etherkit/OpenBeacon/documentation/OpenBeacon BOM.txt

OpenBeacon BOM
Etherkit
15 Aug 2012

| Part (marking)                  | Qty  | Ref                            | P/N
======================================================================================================
Capacitors
| 100n (104)                        12    C1, C2, C9, C10, C11, C13,
                                          C14, C15, C16, C17, C18, C19       
Diodes
| Green LED (5 mm)                  1     D2        
| Red LED (5 mm)                    2     D1, D7        
| 1N5817                            4     D4, D6, D8, D9        
| 1N5227B (3.6V zener)              2     D3, D5        

Connectors
| BNC                               1     J4                                Amphenol 31-5431-10RFX       
| AVR-ISP-6                         1     J3                                3M 929836-09-03      
| +12VDC                            1     J1                                Kobiconn 163-762-E    
| USB B Jack                        1     J2                                FCI 61729-1011BLF

Transistors
| 2N4401                            2     Q1, Q2        
| 2N4403                            1     Q4        
| 2N7000                            1     Q5        
| BD139-16                          1     Q3        

Resistors & Trimmers (0.25 W, unless specified, tolerance band omitted below)
| 1 (brown-black-black-silver)      1     R25  
| 1.5k (brown-green-black-brown)    1     R15       
| 10 (brown-black-black-gold)       2     R13, R21       
| 100k (brown-black-black-orange)   1     R24           
| 10k (brown-black-black-red)       4     R5, R6, R9, R12        
| 1k (brown-black-black-brown)      2     R16, R18  
| 150k (brown-green-black-orange)   3     R1, R2, R3     
| 22 (red-red-black-gold)           2     R14, R19       
| 22k (red-red-black-red)           2     R22, R23
| 330 (orange-orange-black-black)   1     R4
| 4.7k (yellow-purple-black-brown)  1     R17        
| 47 (yellow-purple-black-gold)     1     R7        
| 68 (blue-grey-black-gold)         2     R10, R11   
| 470 trim                          1     R20                               Bournes 3319P-1-471 

Buttons
| Pushbutton                        1     S1                                TE 1571010-1

Transformers
| FT37-43 10T BIFILAR               1     T1        

ICs
| 78L05                             1     U2        
| ATTINY85-20                       1     U1 

Frequency Dependent Components
            |R8
80 Meters   |2.2k (red-red-black-brown)
40 Meters   |2.2k (red-red-black-brown)
30 Meters   |2.2k (red-red-black-brown)
10 Meters   |470 (yellow-purple-black-black)

            |C3         |C4            |C5          |C6          |C7/C8         |C12        |C20/C24      
80 Meters   |20 (red)   |15 C0G (15)   |50 (yellow) |N/A         |150 C0G (151) |68 (68)    |820 (821)
40 Meters   |20 (red)   |10 C0G (10)   |30 (green)  |N/A         |100 C0G (101) |68 (68)    |390 (391)
30 Meters   |10 (blue)  |3.3 C0G (3R3) |30 (green)  |N/A         |47 C0G (47)   |47 (47)    |330 (331)    
10 Meters   |10 (blue)  |2.2 C0G (2.2) |20 (red)    |N/A         |4.7 C0G (4.7) |22 (22)    |180 (181)

            |C22        |C21/C23 |L1/L2                                |L3/L4                         
80 Meters   |1500 (152) |N/A     |22 u (red-red-black, green body)     |3.13 u T37-2 28T (red core)   
40 Meters   |680 (681)  |N/A     |10 u (brown-black-black, green body) |1.46 u T37-2 18T (red core)   
30 Meters   |560 (561)  |N/A     |10 u (brown-black-black, green body) |1.1 u T37-2 16T (red core)    
10 Meters   |270 (271)  |N/A     |1 u (brown-black-gold, green body)   |330 n T37-6 10T (yellow core) 

            |X1
80 Meters   |3.582 MHz
40 Meters   |7.040 MHz
30 Meters   |10.140 MHz
10 Meters   |28.000 MHz

Miscellaneous
| Red Magnet Wire, 28 AWG (feet)    4
| Green Magnet Wire, 28 AWG (feet)  1
| DIP-8 socket                      1                                       FCI DILB8P-223TLF
| PCB
