etherkit/OpenBeacon/documentation/OpenBeacon Windows Build Env Installation.odt

MinGW Installation

1. Review the instructions at http://www.mingw.org/wiki/Getting_Started
2. Download the latest mingw-get-inst from http://sourceforge.net/projects/mingw/files/Installer/mingw-get-inst/
3. Run the executable file and accept all default settings in the installation wizard (MinGW is installed to C:\MinGW)
4. Add C:\MinGW\bin; to the system PATH (instructions to come)

libusb-win32 Installation

5. Download the latest libusb-win32-bin-x.x.x.x from http://sourceforge.net/projects/libusb-win32/files/
6. Unzip the libusb-win32-bin-x.x.x.x ZIP file to a temporary directory
7. In libusb-win32-bin-x.x.x.x\include, rename lusb0_usb.h to usb.h, then copy usb.h to C:\MinGW\include
8. Copy libusb.a from libusb-win32-bin-x.x.x.x\lib\gcc to C:\MinGW\lib
10. In the directory where the openbeacon.c is located, execute gcc openbeacon.c -o openbeacon.exe -lusb
