etherkit/OpenBeacon/documentation/OpenBeacon Schematic Annotated.pdf

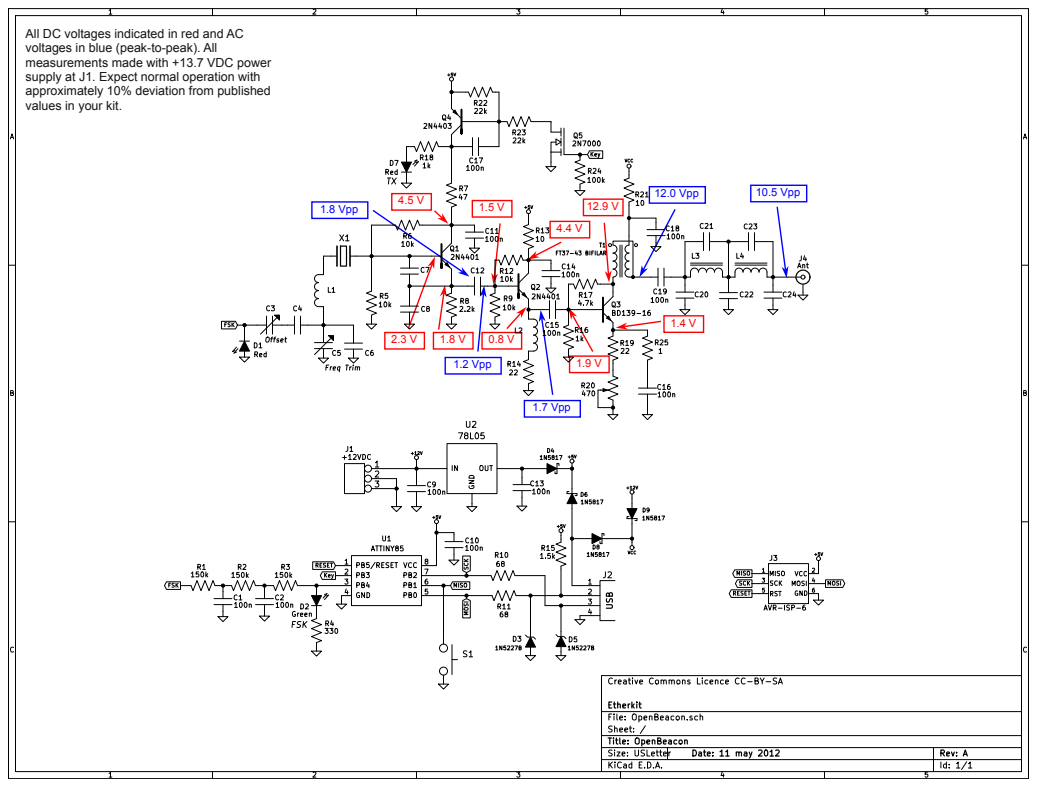
[picture p1: page 1]
1.8 Vpp; 1.2 Vpp; 1.7 Vpp; 12.0 Vpp; 10.5 Vpp

All DC voltages indicated in red and AC
voltages in blue (peaktopeak). All
measurements made with +13.7 VDC power
supply at J1. Expect normal operation with
approximately 10% deviation from published
values in your kit.
