etherkit/OpenBeacon/documentation/OpenBeacon Schematic.pdf

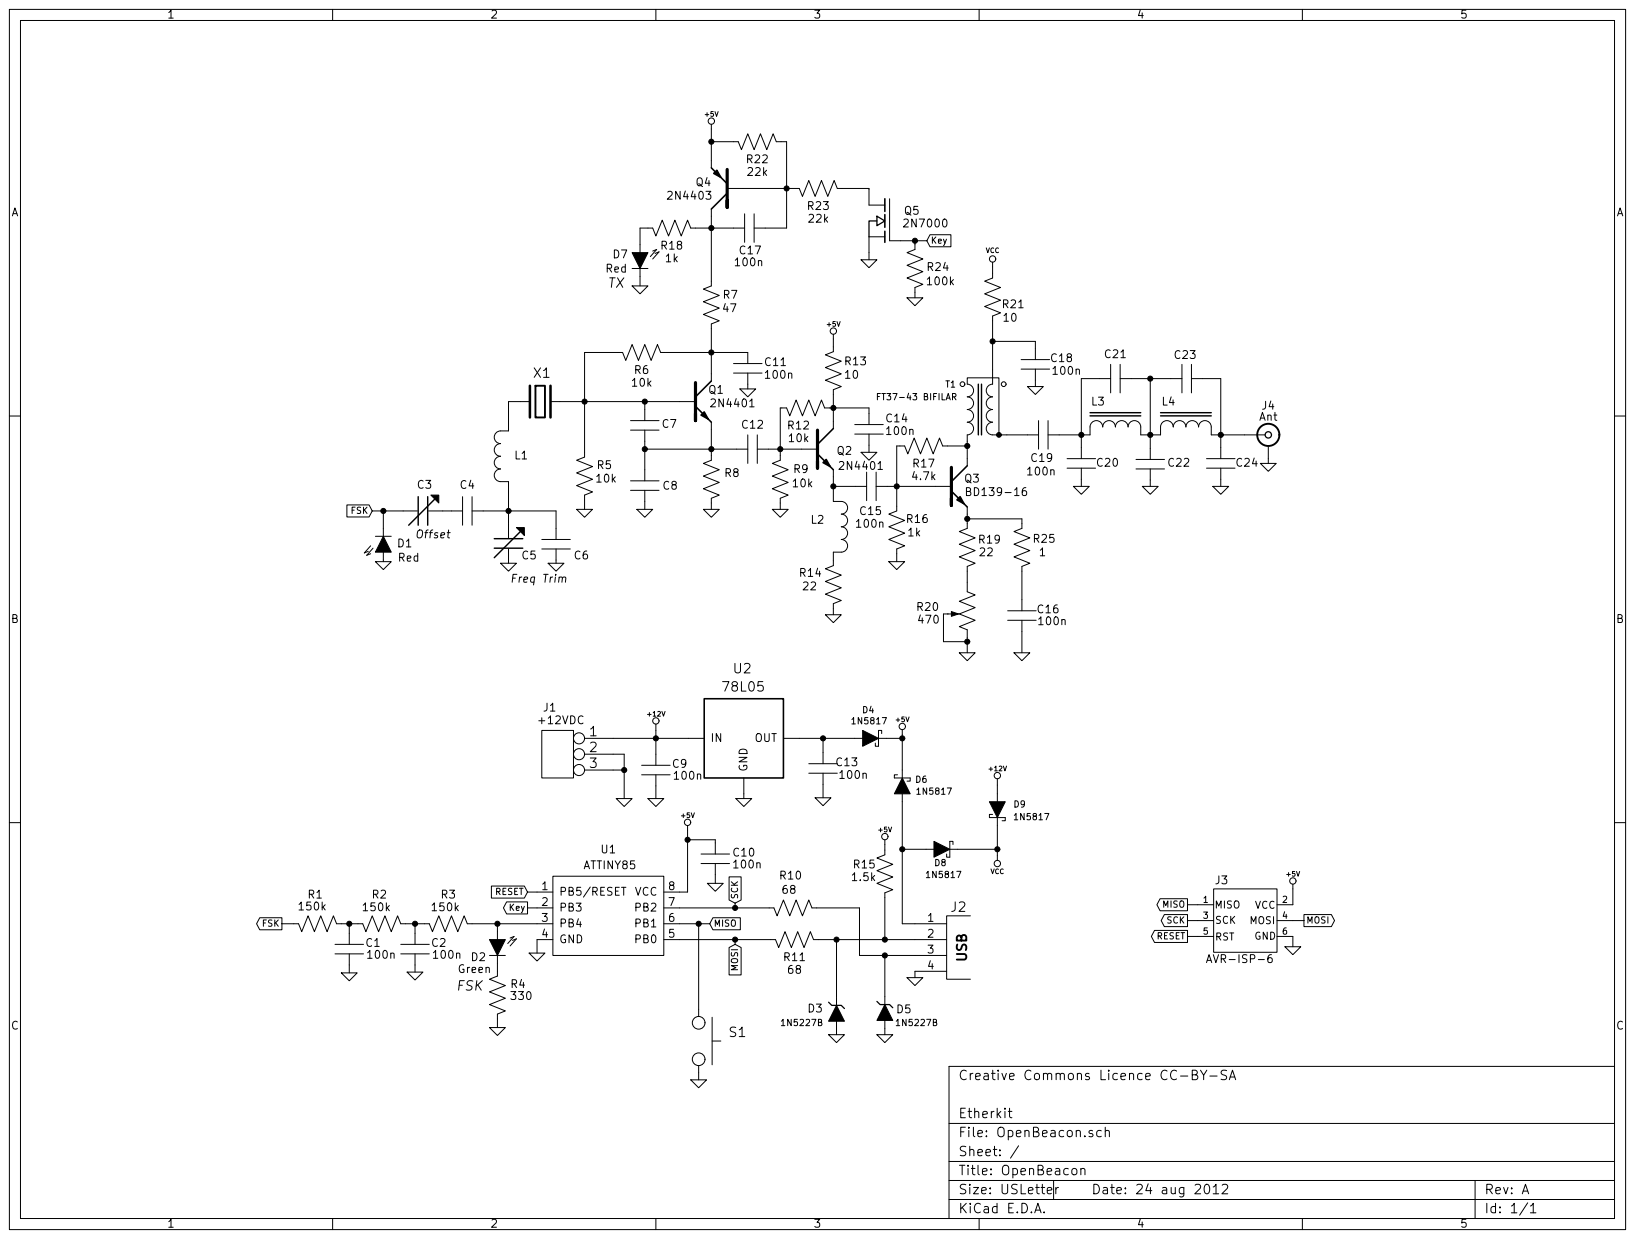
[picture p2: page 1]
