etherkit/OpenBeacon/pcb/OpenBeacon.sch

## KiCad design pcb/OpenBeacon.sch (2012-08-24, an earlier design)

Schematic: OpenBeacon.sch

Parts:
C1, C2, C9, C10, C11, C12, C13, C14, C15, C16, C17, C18, C19: 100n
C3, C5: CTRIM
C4, C6, C7, C8, C20, C21, C22, C23, C24: C
D1, D7: Red
D2: Green
D3, D5: 1N5227B
D4, D6, D8, D9: 1N5817
J1: +12VDC
J2: USB_2
J3: AVR-ISP-6
J4: Ant
L1: L
L2: 10u
L3, L4: L-IRONCORE
Q1, Q2: 2N4401
Q3: BD139-16
Q4: 2N4403
Q5: 2N7000
R1, R2, R3: 150k
R4: 330
R5, R6, R9, R12: 10k
R7: 47
R8: 2.2k
R10, R11: 68
R13, R21: 10
R14: 27
R15: 1.5k
R16, R18: 1k
R17: 4.7k
R19: 22
R20: 470
R22, R23: 22k
R24: 100k
R25: 1
S1: PUSHBUTTON
T1: FT37-43 BIFILAR
U1: ATTINY85
U2: 78L05
X1: CRYSTAL

Notes on the sheet:
Offset
Freq Trim
FSK
