etherkit/OpenBeacon/(commit log)

2012-02-19 First commit - beta
    [$savepcb.brd, OpenBeacon Frequency Dependent Components.ods, OpenBeacon.brd, OpenBeacon.csv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]
2012-02-19 Various bug fixes to client and firmware
    [main.c, modes.h, usbconfig.h]
2012-02-20 Added WPM routines to f/w and client
    [OpenBeacon Frequency Dependent Components.ods, OpenBeacon.brd, OpenBeacon.sch]
2012-02-21 Add Windows executable and driver
2012-02-21 Add PDF schematic
    [OpenBeacon.sch]
2012-02-22 Package Windows INF and drivers in ZIP file
    [OpenBeacon Frequency Dependent Components.ods]
2012-02-25 Correct Windows driver file structure
2012-04-08 Prerelease - WSPR/Glyphcode/message repeat
    [OpenBeacon Frequency Dependent Components.ods, OpenBeacon.brd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]
2012-04-16 Fix glyphcode bug, updated docs and client
    [OpenBeacon.brd, OpenBeacon.sch]
2012-04-23 Correct BOM/remove C6
    [OpenBeacon.brd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]
2012-05-13 Firmware bug in CW WPM, BOM corrections
    [OpenBeacon.sch]
2012-05-28 Add annotated schematic
2012-08-24 Updated BOM and schematic for new bands
    [OpenBeacon.sch]
2013-04-20 BOM change for AVR-ISP header
2019-01-19 Add Raspberry Pi client build
