etherkit/OpenBeacon/(notices)

Notices in the files:
pcb/OpenBeacon.sch:
Creative Commons Licence CC-BY-SA
